mrSerg/homespan-ikea-uppatvind/(commit log)

2026-10-17 Fix HomeKit bugs and add Wi-Fi setup portal
    - Add required CurrentAirPurifierState/TargetAirPurifierState so Home shows speed control
    - Keep Home speed after emulated press, reject Home updates during emulation
    - Turn the original board off from any level, debounce LED level readings
    - Attach LEDC before first use, use HomeSpan watchdog, open-drain button pin
    - Start a setup access point with pairing code when no Wi-Fi is configured
    - Hold the purifier button 5 s to reset Wi-Fi and pairing
    - Rename sketch to match repo folder, fix README, add LICENSE
    Claude-Session: https://claude.ai/code/session_01Tbc3P7XPeSgLzcHMr5yP4Y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
2026-10-17 Enable pull-up on button pin so an unwired pin can't trigger factory reset
    Claude-Session: https://claude.ai/code/session_01Tbc3P7XPeSgLzcHMr5yP4Y
2026-10-17 Blink purifier LED and stop the fan when factory reset is triggered
    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
2026-10-18 Click the original board to the LED level matching the Home speed
2026-10-19 Enable watchdog for improved stability; handle button release since boot; optimize Wi-Fi handling for weak power supply
2026-10-19 Document power-up workaround for the weak purifier supply and the 5 s watchdog
2026-10-19 Expose DHT11 temperature and humidity in Apple Home when the sensor is connected
